1stage/c64-krv-switcher/krv_picture.jpg

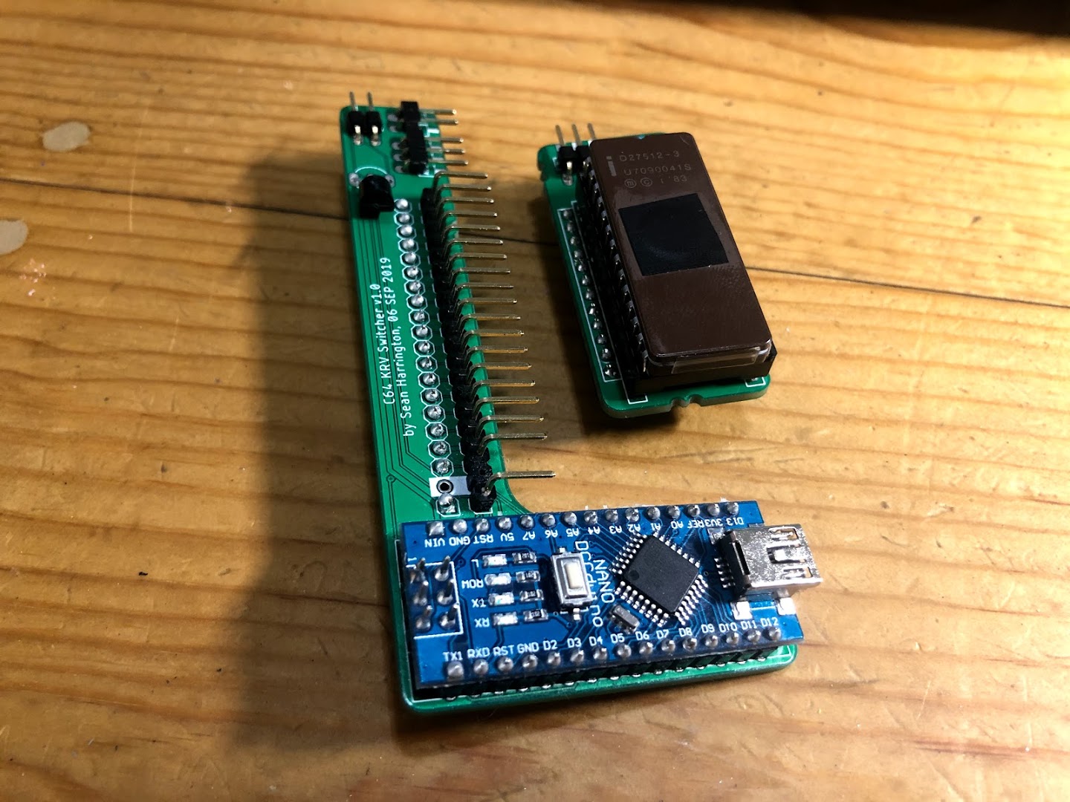
krv_picture.jpg
