1stage/c64-krv-switcher/C64_Switcher_SCHEMATIC_v1-0.pdf

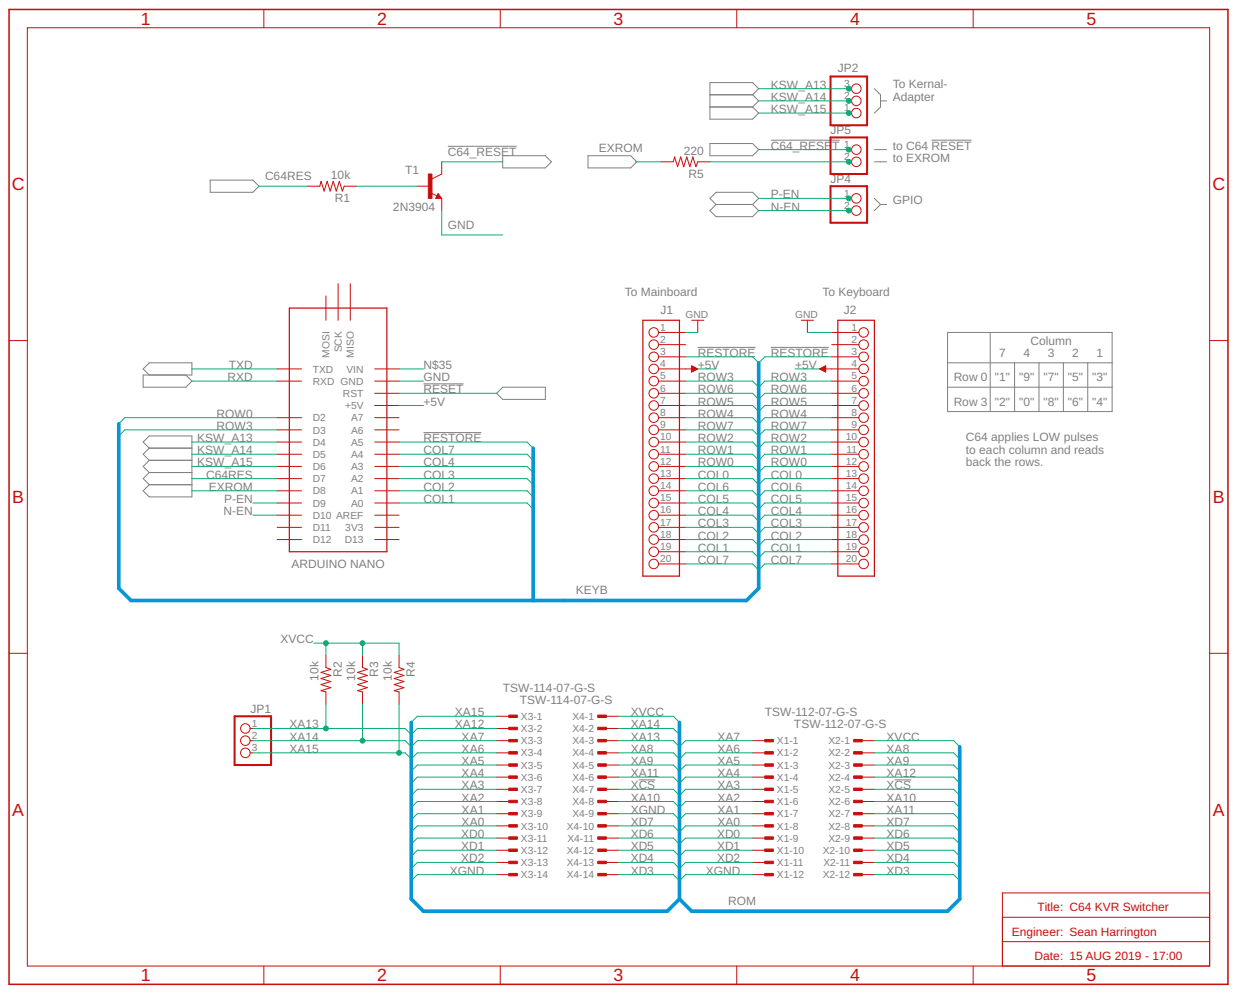
[picture p2: page 1]

SCK MOSI ARDUINO NANO
3V3 AREFA0A1A2A3A4A5A6A7 +5V RST GND
D12 D11 D10 D9 D8 D7 D6 D5 D4 D3 D2 RXD

Column Row 0 7 4 3 2 1

Row 3 | "2" | "0" | "8" | "6" | "4"

C64 applies LOW pulses
to each column and reads back the rows.

C64 KVR Switcher Sean Harrington
