1stage/c64-krv-switcher/(commit log)

2019-11-11 Add files via upload
    Sketch for the on-board Arduino Nano device
2020-01-28 Update c64krvsw.ino
    Completely removed keyboard scanning resets and RESTORE key long hold for RESET. The "timeout" scans were interfereing (not working) with cartridges.
    [c64krvsw.ino]
2025-01-09 Upload the Gerber files for the C64 KRV Switcher boards.
